josuenim/PIDRobotDiferencial/README.md

# PIDRobotDiferencial
Control de motores con encoder de Cuadratura por medio de sistema PID

  Uso de Arduino nano para el control de motores con encoders tipo hall ambos motores son accionado  por un puente h L298N, adicionalmente se usa un sensor ultrasonico para controlar 
la rotacion de los motores.
  Uso de Python y librerias de control PID.
