josuenim/PIDRobotDiferencial/Proyecto_Carro_SC/Robot_Uniciclo_ArduinoConexiones.png

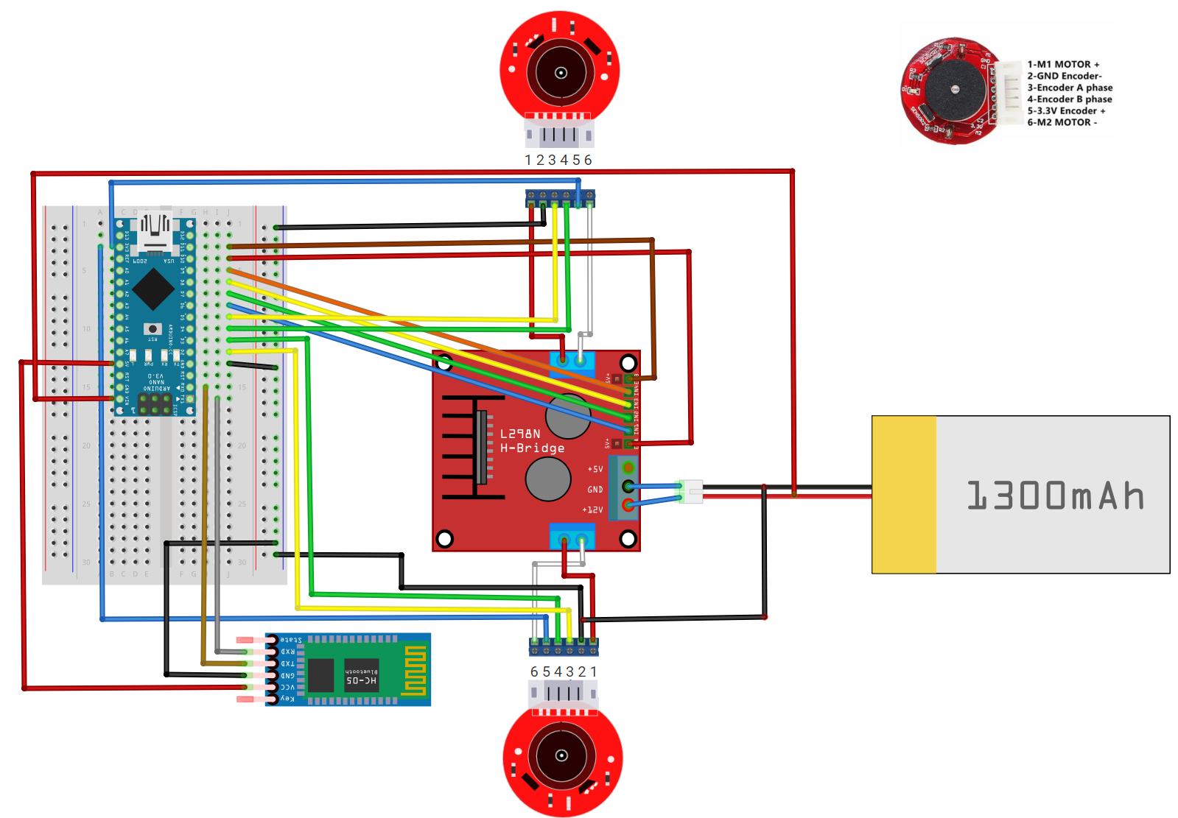
Proyecto_Carro_SC/Robot_Uniciclo_ArduinoConexiones.png
